parkourlrc/pcb-tobycm--quick-nic-ac4ba9df50/cad/quick nic assembly.step

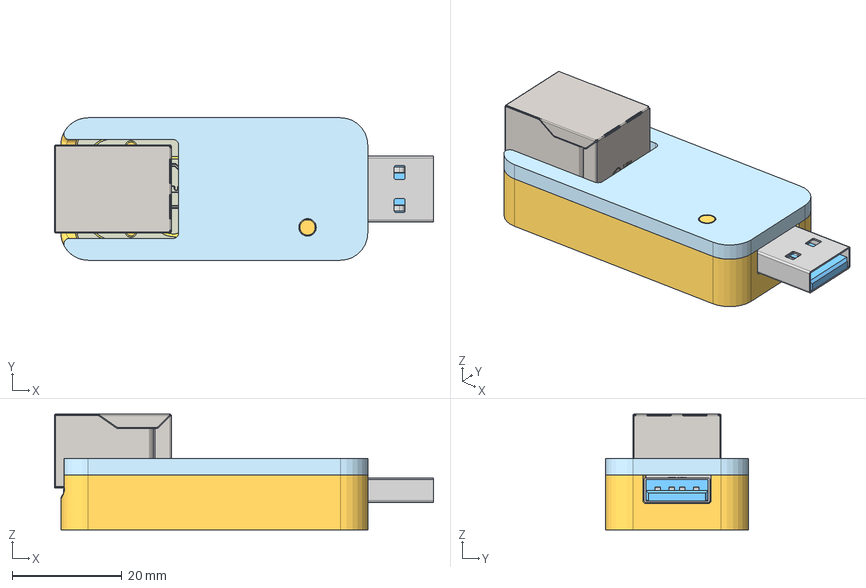
[picture p5: CAD file, 2026-11-06]
cad/quick nic assembly.step
69.1 x 26.0 x 21.1 mm
quick-nic_copper x 77
C_0603_1608Metric_9
C_1206_3216Metric
Crystal_SMD_3225-4Pin_3.2x2.5mm
C_0603_1608Metric_5
C_0603_1608Metric_2
R_0603_1608Metric
C_0603_1608Metric_7
quick-nic_PCB
QFN-40-1EP_5x5mm_Pitch0.4mm
C_0603_1608Metric_6
C_0603_1608Metric_4
USB-3.0-A-SMD_HC-USB3.0-C26 x 2
Lid
C_0603_1608Metric
RJ45-TH_HR911130A x 4
C_0603_1608Metric_10
C_0603_1608Metric_11
R_0603_1608Metric_4
C_0603_1608Metric_3
C_0603_1608Metric_1
R_0603_1608Metric_3
SOT-23-6
R_0603_1608Metric_2
C_0603_1608Metric_8
C_0603_1608Metric_12
R_0603_1608Metric_1
R_0805_2012Metric
