parkourlrc/pcb-tobycm--quick-nic-ac4ba9df50/cad/quick-nic.step

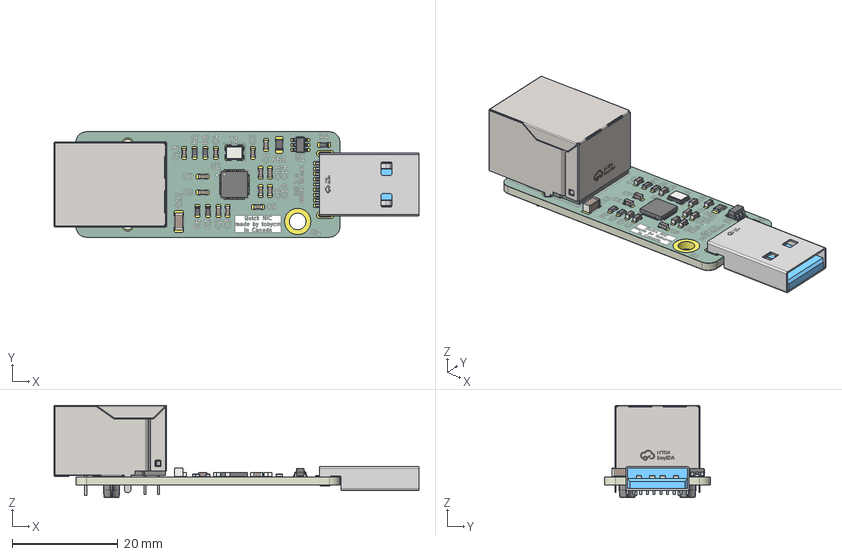
[picture p6: CAD file, 2026-11-06]
cad/quick-nic.step
69.1 x 20.0 x 17.5 mm
C_0603_1608Metric x 13
Crystal_SMD_3225-4Pin_3.2x2.5mm
USB-3.0-A-SMD_HC-USB3.0-C26
R_0603_1608Metric x 5
C_1206_3216Metric
SOT-23-6
QFN-40-1EP_5x5mm_Pitch0.4mm
R_0805_2012Metric
RJ45-TH_HR911130A
quick-nic_copper
quick-nic_silkscreen x 2
quick-nic_soldermask x 2
quick-nic_PCB
