parkourlrc/pcb-tobycm--quick-nic-ac4ba9df50/cad/quick nic case - Body.step

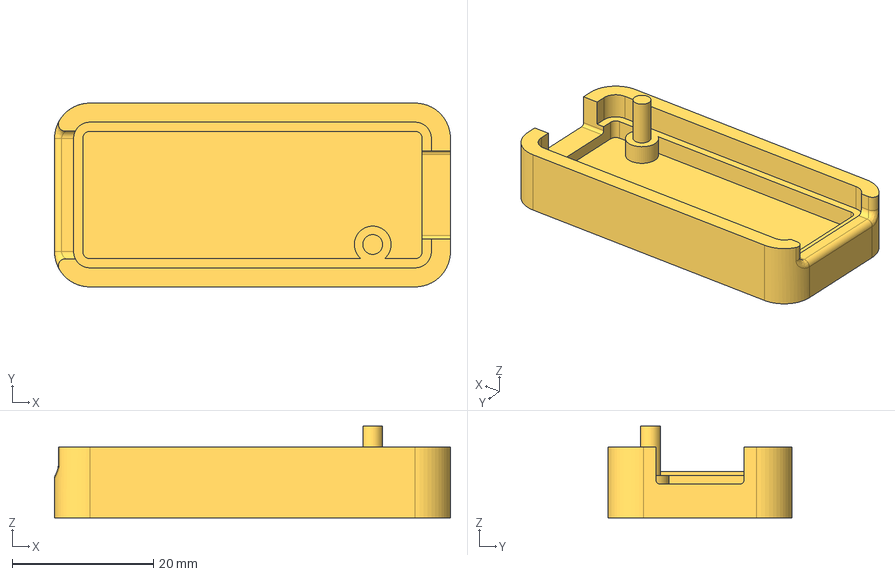
[picture p7: CAD file, 2026-11-06]
cad/quick nic case - Body.step
56.0 x 26.0 x 13.0 mm
