parkourlrc/pcb-tobycm--quick-nic-ac4ba9df50/cad/quick nic case - Lid.step

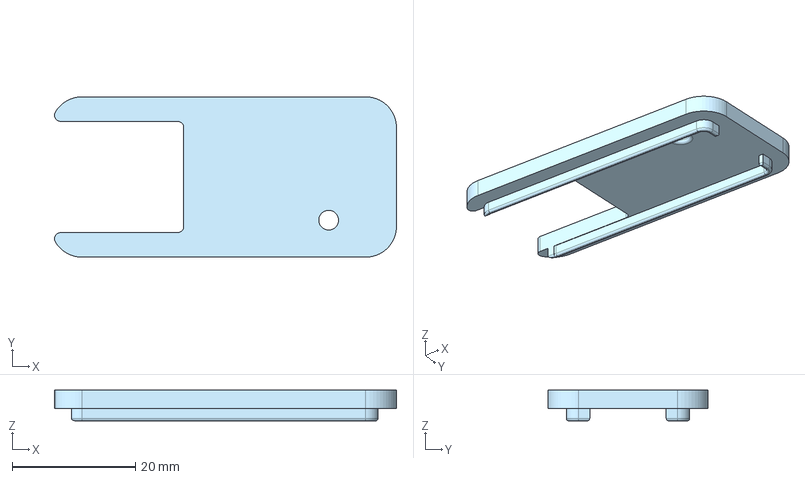
[picture p8: CAD file, 2026-11-06]
cad/quick nic case - Lid.step
55.5 x 26.0 x 5.00 mm
