parkourlrc/pcb-tobycm--quick-nic-ac4ba9df50/pcb/quick-nic.kicad_pcb

## KiCad design pcb/quick-nic.kicad_pcb (2026-11-06)

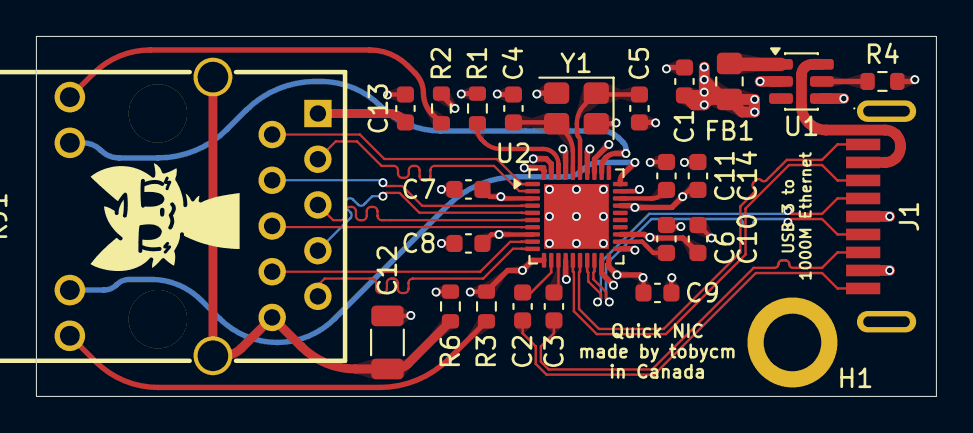
[picture p9: board quick-nic.kicad_pcb from above]

Board: 6 copper layers, 50.0 x 20.0 mm, 26 parts (0 on the bottom side), 34 nets.

Parts:
C1, C11: 10u; C_0603_1608Metric
C2, C3, C13: 100n; C_0603_1608Metric
C4, C5: 33p; C_0603_1608Metric
C6, C7, C8, C9, C10, C14: 1u; C_0603_1608Metric
C12: 1n; C_1206_3216Metric
FB1: 220Ω@100MHz; R_0805_2012Metric_Pad1.20x1.40mm_HandSolder
H1: MountingHole; MountingHole_3.2mm_M3_Pad
J1: HC-USB3.0-C26; USB-3.0-A-SMD_HC-USB3.0-C26
R1: 2.49k; R_0603_1608Metric
R2, R3: 470; R_0603_1608Metric
R4: 62k; R_0603_1608Metric
R6: 1M; R_0603_1608Metric
RJ1: HR911130A; RJ45-TH_HR911130A
U1: CH217A; SOT-23-6
U2: RTL8153B-VB-CG; QFN-40-1EP_5x5mm_P0.4mm_EP3.6x3.6mm
Y1: 25Mhz; Crystal_SMD_3225-4Pin_3.2x2.5mm

Connections:
+1V0: C7.1, C8.1, U2.3 (AVDD10), U2.8 (AVDD10), U2.14 (U3VDD10), U2.19 (U2VDD10), U2.34 (DVDD10), U2.37 (AVDD10)
+1V0_UPS: C6.1, U2.22 (DVDD10_UPS)
+3V3: C9.1, C10.1, R2.2, R3.2, U2.11 (AVDD33), U2.20 (AVDD33), U2.23 (DVDD33), U2.33 (DVDD33), U2.39 (AVDD33), U2.40 (AVDD33)
+5V: C1.2, C14.1, FB1.2, U2.21 (VDD5), U2.27 (VDDREG5)
/D+: J1.3 (D+), U2.18 (U2DP)
/D-: J1.2 (D-), U2.17 (U2DM)
/LED0: RJ1.12, U2.32 (LED0/SPICSB)
/LED1: RJ1.13, U2.30 (EESK/LED1/SPISCK)
/MDI0+: RJ1.P2 (MDI0+), U2.1 (MDIP0)
/MDI0-: RJ1.P3 (MDI0-), U2.2 (MDIN0)
/MDI1+: RJ1.P4 (MDI1+), U2.4 (MDIP1)
/MDI1-: RJ1.P7 (MDI1-), U2.5 (MDIN1)
/MDI2+: RJ1.P5 (MDI2+), U2.6 (MDIP2)
/MDI2-: RJ1.P6 (MDI2-), U2.7 (MDIN2)
/MDI3+: RJ1.P8 (MDI3+), U2.9 (MDIP3)
/MDI3-: RJ1.P9 (MDI3-), U2.10 (MDIN3)
/SSRX+: C3.2, J1.6 (SSRX+)
/SSRX-: C2.2, J1.5 (SSRX-)
/SSTX+: J1.9 (SSTX+), U2.16 (U3SSRXP)
/SSTX-: J1.8 (SSTX-), U2.15 (U3SSRXN)
GND: C1.1, C4.1, C5.1, C6.2, C7.2, C8.2, C9.2, C10.2, C11.1, C12.2, C13.2, C14.2, J1.4 (GND), J1.7 (DRAIN), J1.SH (SHIELD), R1.2, R4.1, R6.1, U1.2 (GND), U1.4 (EN#), U2.29 (GND), U2.41 (EP), Y1.2 (G), Y1.4 (G)
unnamed: C12.1, R6.2, RJ1.P10, RJ1.SHIELD0, RJ1.SHIELD1
unnamed: C13.1, RJ1.P1
unnamed: J1.1 (VBUS), U1.6 (VIN)
unnamed: R2.1, RJ1.11
unnamed: R3.1, RJ1.14
unnamed: R4.2, U1.5 (ISET)
unnamed: FB1.1, U1.1 (VOUT)
unnamed: C5.2, U2.35 (CKXTAL1), Y1.1
unnamed: C4.2, U2.36 (CKXTAL2), Y1.3
unnamed: C11.2, U2.28 (REGOUT)
unnamed: R1.1, U2.38 (RSET)
unnamed: C2.1, U2.12 (U3SSTXN)
unnamed: C3.1, U2.13 (U3SSTXP)
