parkourlrc/pcb-tobycm--quick-nic-ac4ba9df50/(commit log)

2026-10-30 update pcb with new name
    [quick-nic.kicad_pcb]
2026-11-06 designed case
    [Banana.STEP, quick nic assembly.step, quick nic case - Body.step, quick nic case - Lid.step, quick-nic.kicad_pcb, quick-nic.step]
2026-11-06 add cad renders in readme
